Hoffmeyers/LWERA-SMPS/phone charger smps/CAD MODELS/SMPS CHARGER/SMPS earth plug.stl

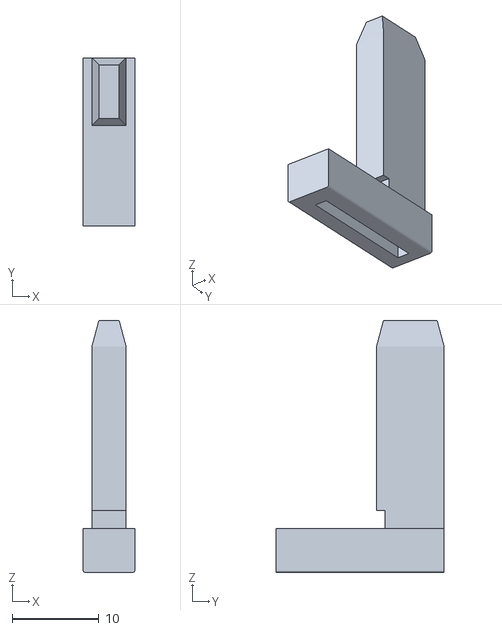
[picture p1: CAD file, 2025-10-01]
phone charger smps/CAD MODELS/SMPS CHARGER/SMPS earth plug.stl
5.95 x 19.4 x 29.1
