Hoffmeyers/LWERA-SMPS/phone charger smps/CAD MODELS/SMPS CHARGER/to be printed/SMPS head.stl

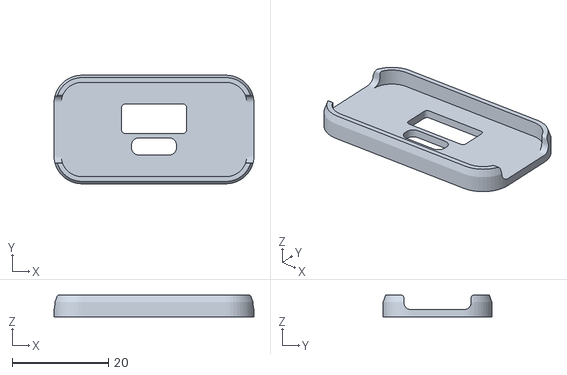
[picture p2: CAD file, 2025-10-01]
phone charger smps/CAD MODELS/SMPS CHARGER/to be printed/SMPS head.stl
41.6 x 22.6 x 4.50
