Hoffmeyers/LWERA-SMPS/phone charger smps/comps/1N4148WSQ-7-F/1N4148WSQ-7-F.step

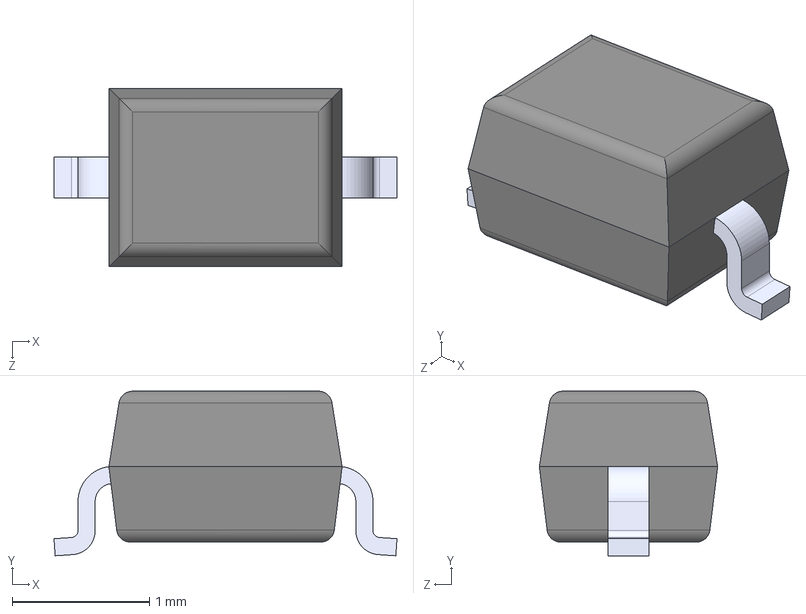
[picture p3: CAD file, 2025-10-01]
phone charger smps/comps/1N4148WSQ-7-F/1N4148WSQ-7-F.step
2.50 x 1.20 x 1.30 mm
