Hoffmeyers/LWERA-SMPS/phone charger smps/comps/RSTA-2.5-BULK/RSTA-2.5-BULK.step

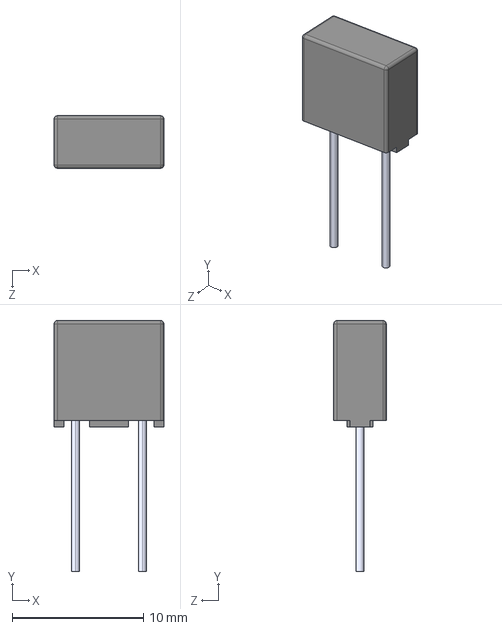
[picture p4: CAD file, 2025-10-01]
phone charger smps/comps/RSTA-2.5-BULK/RSTA-2.5-BULK.step
8.35 x 19.1 x 4.00 mm
