Hoffmeyers/LWERA-SMPS/phone charger smps/comps/USB1046-GF-0190-L-B-A_REVB4/USB1046-GF-0190-L-B-A_REVB4.step

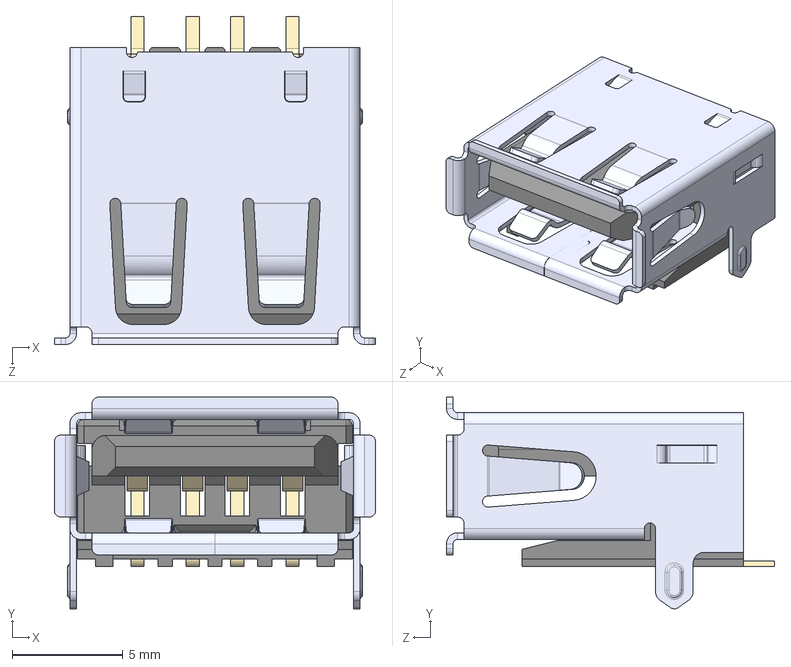
[picture p5: CAD file, 2025-10-01]
phone charger smps/comps/USB1046-GF-0190-L-B-A_REVB4/USB1046-GF-0190-L-B-A_REVB4.step
14.5 x 9.55 x 14.8 mm
