Hoffmeyers/LWERA-SMPS/phone charger smps/comps/USB4515-GF-A_REVA/USB4515-GF-A_REVA.step

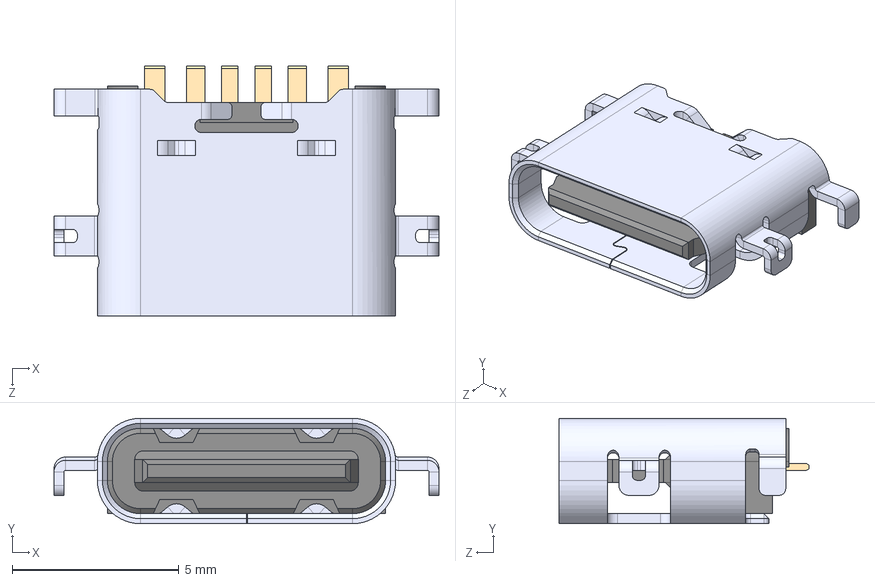
[picture p6: CAD file, 2025-10-01]
phone charger smps/comps/USB4515-GF-A_REVA/USB4515-GF-A_REVA.step
11.5 x 3.16 x 7.50 mm
