Hoffmeyers/LWERA-SMPS/phone charger smps/comps/VIPER26LD/VIPER26LD.step

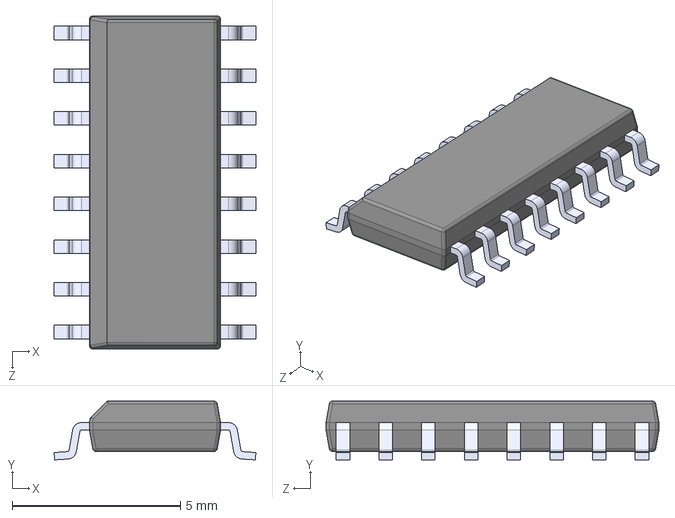
[picture p7: CAD file, 2025-10-01]
phone charger smps/comps/VIPER26LD/VIPER26LD.step
6.00 x 1.75 x 9.90 mm
