Hoffmeyers/LWERA-SMPS/phone charger smps/comps/VO617A-3X018T/VO617A-3X018T.step

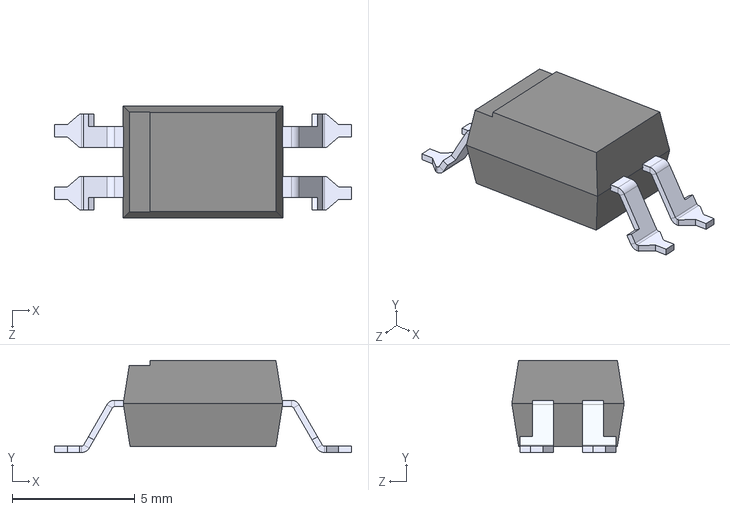
[picture p8: CAD file, 2025-10-01]
phone charger smps/comps/VO617A-3X018T/VO617A-3X018T.step
12.1 x 3.75 x 4.58 mm
