Hoffmeyers/LWERA-SMPS/phone charger smps/comps/WE-FB_EP7_SCH1/WE-FB_EP7_SCH1.step

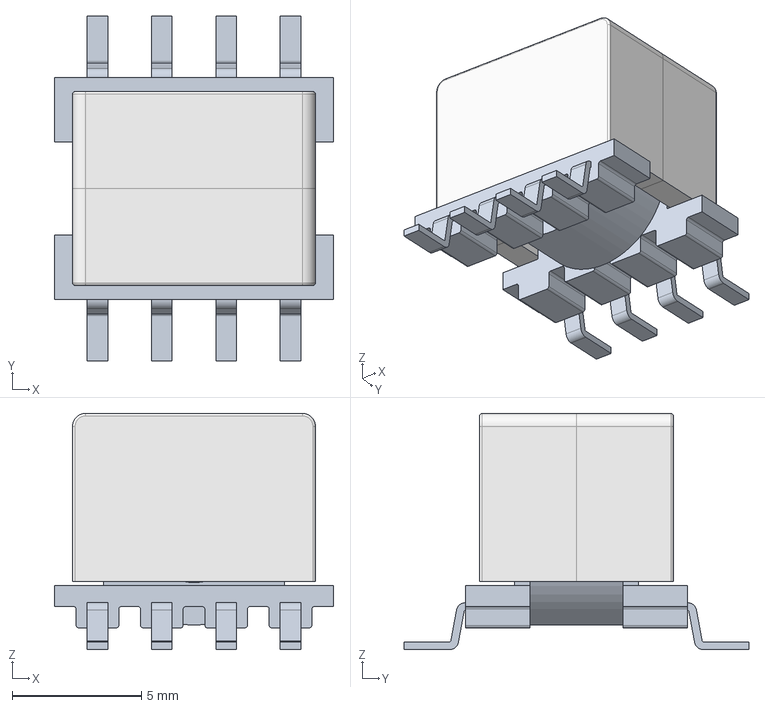
[picture p9: CAD file, 2025-10-01]
phone charger smps/comps/WE-FB_EP7_SCH1/WE-FB_EP7_SCH1.step
10.8 x 13.3 x 9.14 mm
