Hoffmeyers/LWERA-SMPS/phone charger smps/comps/WE-PD_1210/WE-PD_1210.step

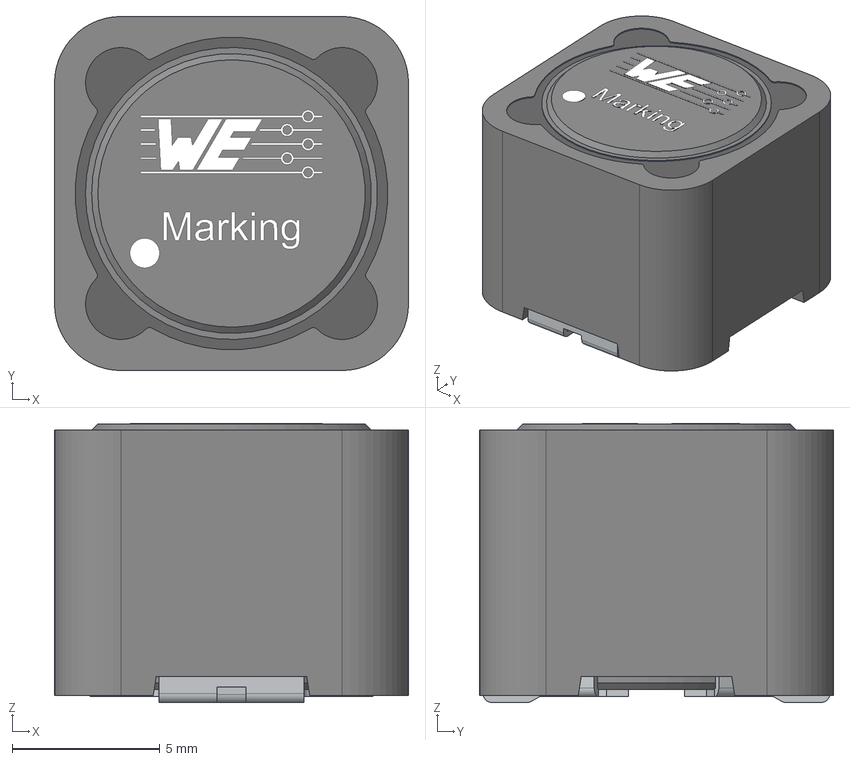
[picture p10: CAD file, 2025-10-01]
phone charger smps/comps/WE-PD_1210/WE-PD_1210.step
12.0 x 12.0 x 9.46 mm
Core
ShieldRing
Glue
Leadframe
