Hoffmeyers/LWERA-SMPS/phone charger smps/CAD MODELS/SMPS CHARGER/SMPS base.stl

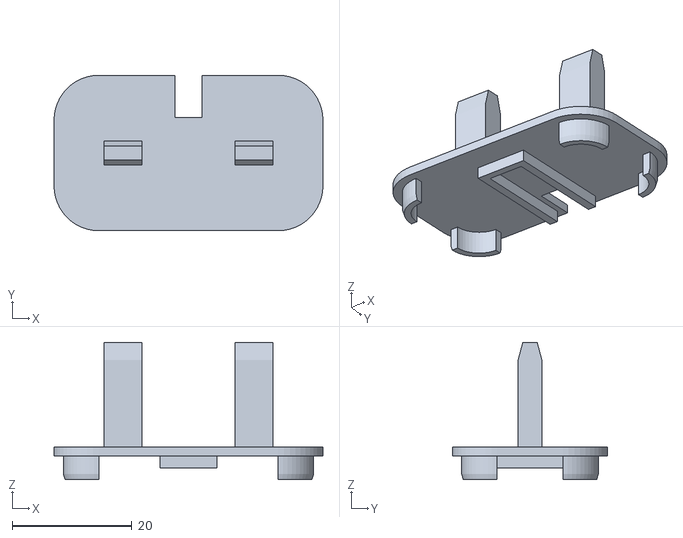
[picture p11: CAD file, 2025-10-01]
phone charger smps/CAD MODELS/SMPS CHARGER/SMPS base.stl
45.0 x 26.0 x 23.0
