Hoffmeyers/LWERA-SMPS/phone charger smps/CAD MODELS/SMPS CHARGER/to be printed/SMPS earth plug 2.stl

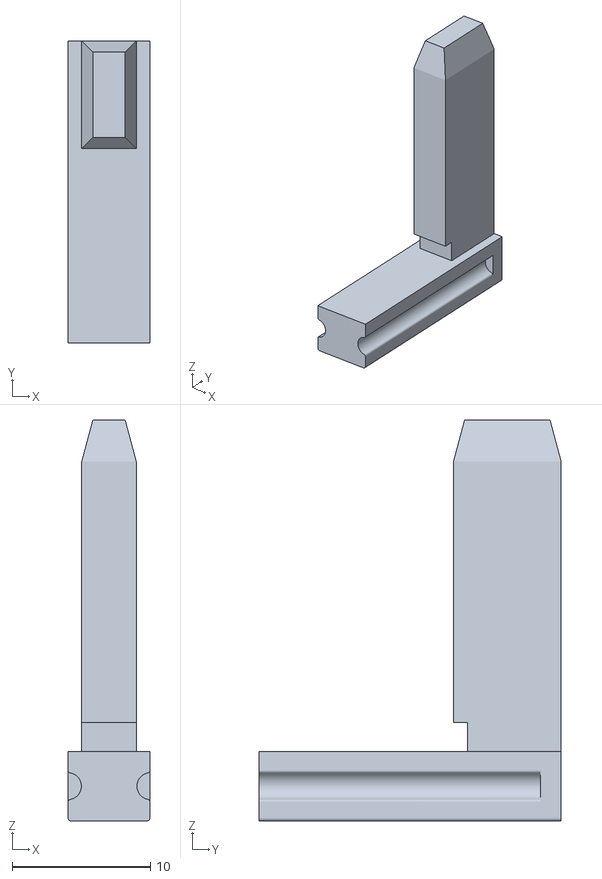
[picture p12: CAD file, 2025-10-01]
phone charger smps/CAD MODELS/SMPS CHARGER/to be printed/SMPS earth plug 2.stl
5.95 x 21.9 x 29.1
