Hoffmeyers/LWERA-SMPS/phone charger smps/CAD MODELS/SMPS CHARGER/to be printed/SMPS case.stl

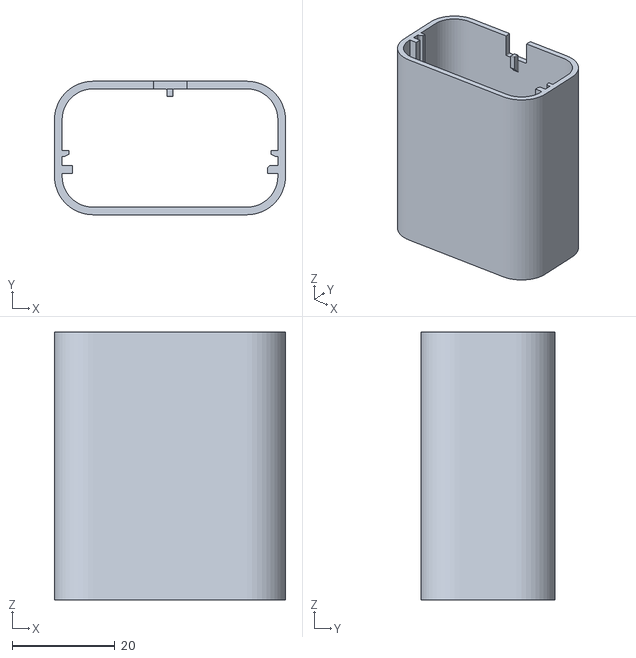
[picture p13: CAD file, 2025-10-01]
phone charger smps/CAD MODELS/SMPS CHARGER/to be printed/SMPS case.stl
45.0 x 26.0 x 52.2
