Hoffmeyers/LWERA-SMPS/(list of files, cad)

Other CAD files:
phone charger smps/CAD MODELS/SMPS CHARGER/to be printed/SMPS base 2.stl
phone charger smps/CAD MODELS/SMPS CHARGER/to be printed/SMPS case 2.stl
phone charger smps/CAD MODELS/SMPS CHARGER/to be printed/case 3.stl
