Hoffmeyers/LWERA-SMPS/phone charger smps/SMPS/SMPS.kicad_pcb

## KiCad design phone charger smps/SMPS/SMPS.kicad_pcb (2025-10-01)

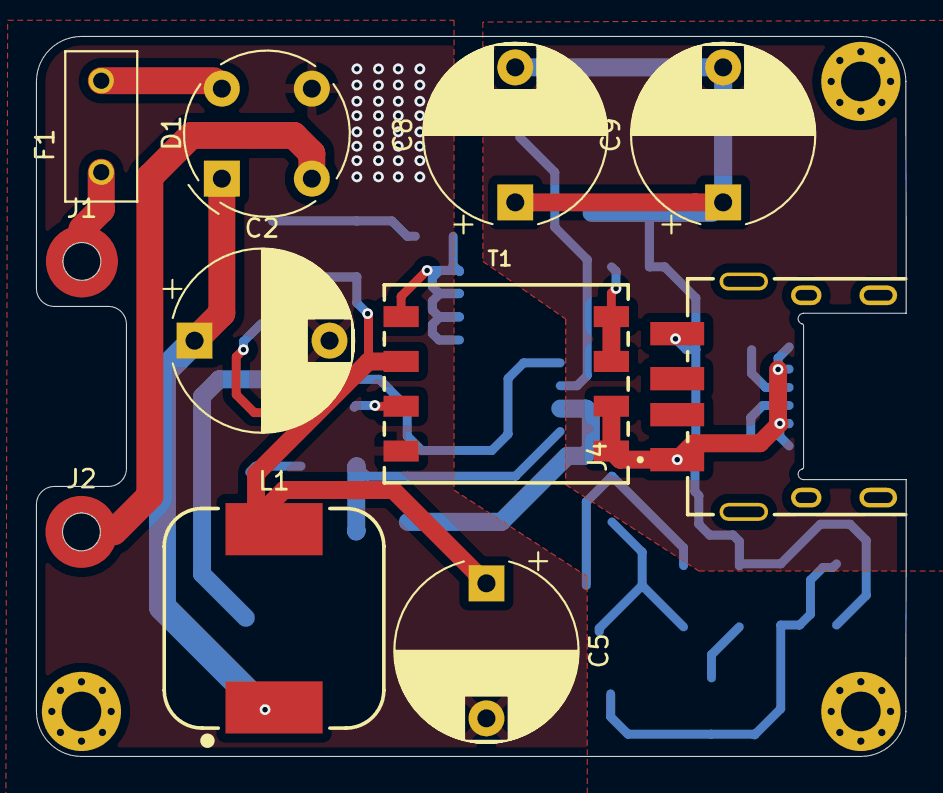
[picture p14: board SMPS.kicad_pcb from above]

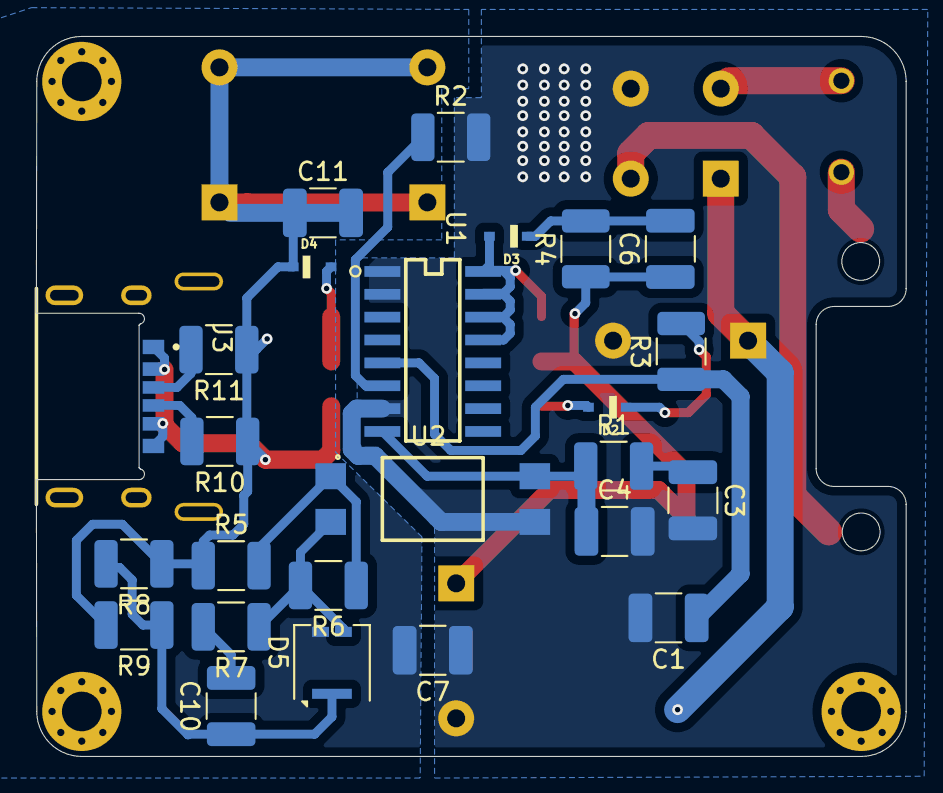
[picture p15: board SMPS.kicad_pcb from below]

Board: 2 copper layers, 48.3 x 40.0 mm, 36 parts (25 on the bottom side), 23 nets.

Parts:
C1, C6: 1nF; C_1210_3225Metric_Pad1.33x2.70mm_HandSolder
C2, C5: 12uF; CP_Radial_D10.0mm_P7.50mm
C3: 330nF; C_1210_3225Metric_Pad1.33x2.70mm_HandSolder
C4: 220pF; C_1210_3225Metric_Pad1.33x2.70mm_HandSolder
C7: C; C_1210_3225Metric_Pad1.33x2.70mm_HandSolder
C8, C9: 560uF; CP_Radial_D10.0mm_P7.50mm
C10: 12nF; C_1210_3225Metric_Pad1.33x2.70mm_HandSolder
C11: 1uF; C_1210_3225Metric_Pad1.33x2.70mm_HandSolder
D1: RB157; Diode_Bridge_Round_D9.0mm
D2, D3, D4: 1N4148WSQ-7-F; SOD2513X120N
D5: D_Schottky_Dual_Series_CAK; Littelfuse_PolyZen-LS
F1: RSTA-2.5-BULK; FUSE_RST-1-BULK
J1, J2: Screw_Terminal_01x01; Mounting_Wuerth_WA-SMSI-M1.6_H1mm_9774010633
J3: USB4515-GF-A_REVA; GCT_USB4515-GF-A_REVA
J4: USB1046-GF-0190-L-B-A_REVB4; GCT_USB1046-GF-0190-L-B-A_REVB4
L1: WE-PD_1210
R1: 3.3K; R_1210_3225Metric_Pad1.30x2.65mm_HandSolder
R2: R; R_1210_3225Metric_Pad1.30x2.65mm_HandSolder
R3: 33; R_1210_3225Metric_Pad1.30x2.65mm_HandSolder
R4: 220k; R_1210_3225Metric_Pad1.30x2.65mm_HandSolder
R5: 100; R_1210_3225Metric_Pad1.30x2.65mm_HandSolder
R6: 12k; R_1210_3225Metric_Pad1.30x2.65mm_HandSolder
R7: 1M; R_1210_3225Metric_Pad1.30x2.65mm_HandSolder
R8: 130K; R_1210_3225Metric_Pad1.30x2.65mm_HandSolder
R9: 43K; R_1210_3225Metric_Pad1.30x2.65mm_HandSolder
R10, R11: 10k; R_1210_3225Metric_Pad1.30x2.65mm_HandSolder
T1: WE-FB_EP7_SCH1; WE-FB_EP7_P11.68
U1: VIPER26LD; SO16N
U2: VO617A-3X018T; SOIC254P1210X390-4N

Connections:
GND1: C1.2, C2.2, C3.2, C4.2, C5.2, C7.1, D1.3 (-), R2.2, T1.1, U1.1 (GND), U1.2 (GND), U1.7 (FB), U2.3
GND2: C7.2, C8.2, C9.2, C11.2, D5.2 (A), J3.A12 (GND), J3.B12 (GND), J4.4 (GND), R9.2, T1.7, T1.8
unnamed: C3.1, R1.2
unnamed: C5.1, C6.1, L1.2, R4.1, T1.3
unnamed: C6.2, D3.C, R4.2
unnamed: C10.2, R7.2
unnamed: C2.1, D1.1 (+), L1.1
unnamed: D1.4, F1.2
unnamed: D2.A, T1.2
unnamed: D2.C, R3.2
unnamed: D3.A, T1.4, U1.13 (DRAIN), U1.14 (DRAIN), U1.15 (DRAIN), U1.16 (DRAIN)
unnamed: D4.A, T1.5, T1.6
unnamed: D5.3 (K), R6.2, R7.1, U2.2
unnamed: C10.1, D5.1 (common), R8.2, R9.1
unnamed: F1.1, J1.1
unnamed: D1.2, J2.1
unnamed: J3.A5 (CC1), R11.2
unnamed: J3.B5 (CC2), R10.2
unnamed: C8.1, C9.1, C11.1, D4.C, J3.A9 (VBUS), J3.B9 (VBUS), J4.1 (VCC), R5.1, R8.1, R10.1, R11.1
unnamed: R5.2, R6.1, U2.1
unnamed: C4.1, R1.1, U1.8 (COMP), U2.4
unnamed: R2.1, U1.6 (LIM)
unnamed: C1.1, R3.1, U1.5 (VDD)
